DynamicPerception/NMX_3-Axis_Hardware/README.md

NMX_3-Axis_Hardware
===================

3-Axis version of the nanoMoCo controller with Bluetooth LE
