DynamicPerception/NMX_3-Axis_Hardware/NMX-200 Fab and Assm Files - Rev3/NMX-200_BOM-rev3.xls

Company: |  |  | Dynamic Perception
Device: |  |  | NMX-200-rev3
SMD Parts: |  |  | 78
Through Hole Parts : |  |  | 9
SMD Both Sides: |  |  | Yes
Designator | Value | Device | Package | Description | Manufacturer | Manufacturer Part # | Supplier | Supplier Part # | Qty / Board | Notes
S1 |  | TAC_SWITCH | TACTICLE_SWITCH_SMD_EVQP0_BOT | Momentary Switch | Panasonic Electronic Components | EVQ-P0Q02Q | Digi-Key | P12967SDKR-ND | 1
U10 |  | TXB0104PWR | TSSOP14 | 4-Bit Bi-Directional Level Shifter | Texas Instruments | TXB0104PWR | Digi-Key | 296-21929-6-ND | 1
C1, C4, C5, C7, C10, C11, C12, C13, C14, C15, C17, C18, C20 | .1uF | CAP0402-CAP | 0402-CAP | Capacitor | Taiyo Yuden | TMK105BJ104KV-F | Digi-Key | 587-1456-1-ND | 13
R18 | 0.01 | R-US_R1206 | R1206 | RESISTOR, American symbol | TE Connectivity | RLP73V2BR010JTD | Digi-Key | A109818DKR-ND | 1
R19 | 100 | R-US_R0402 | R0402 | RESISTOR, American symbol | Yageo | RC0402FR-07100RL | Digi-Key | 311-100LRDKR-ND | 1
C6 | 100uF | CAP_POLD | PANASONIC_D | Capacitor Polarized | Panasonic Electronic Components | EEE-1EA101XP | Digi-Key | PCE3898DKR-ND | 1
J2 | 10118193-0001LF | USB10118193-0001LF | 10118193-0001LF |  | FCI | 10118193-0001LF | Digi-Key | 609-4616-1-ND | 1
R4, R5, R8, R17, R20, R21, R22, R23, R24 | 10k | R-US_R0402 | R0402 | RESISTOR, American symbol | Yageo | RC0402FR-0710KL | Digi-Key | 311-10.0KLRTR-ND | 9
C2, C3, C19 | 10uF | CAP_POL1206 | EIA3216 | Capacitor Polarized | Kemet | T491A106M016AT | Digi-Key | 399-3687-6-ND | 3
R9 | 120 | R-US_R0402 | R0402 | RESISTOR, American symbol | Yageo | RC0402JR-07120RL | Digi-Key | 311-120JRDKR-ND | 1
C8, C9 | 12pF | CAP0402-CAP | 0402-CAP | Capacitor | TDK Corporation | C1005C0G1H120J050BA | Digi-Key | 445-1236-6-ND | 2
R2, R3, R13, R14 | 180 | R-US_R0402 | R0402 | RESISTOR, American symbol | Yageo | RC0402FR-07180RL | Digi-Key | 311-180LRDKR-ND | 4
C16 | 1uF | CAP0402-CAP | 0402-CAP | Capacitor | TDK Corporation | C1005X5R1C105K050BC | Digi-Key | 445-4978-6-ND | 1
R6, R7 | 22 | R-US_R0402 | R0402 | RESISTOR, American symbol | Yageo | RC0402JR-0722RL | Digi-Key | 311-22JRDKR-ND | 2
U9 | 3.2X2.5MM_CRYSTAL | 3.2X2.5MM_CRYSTAL | 3.2X2.5MM |  | AVX Corp/Kyocera Corp | CX3225SB16000E0FPZ25 | Digi-Key | 478-4815-6-ND | 1
R10, R11, R15, R16 | 330 | R-US_R0402 | R0402 | RESISTOR, American symbol | Yageo | RC0402FR-07330RL | Digi-Key | 311-330LRDKR-ND | 4
R25 | 40.2k | R-US_R0402 | R0402 | RESISTOR, American symbol | Yageo | RC0402FR-0740K2L | Digi-Key | 311-40.2KLRDKR-ND | 1
R1, R12 | 5.1k | R-US_R0402 | R0402 | RESISTOR, American symbol | Yageo | RC0402JR-075K1L | Digi-Key | 311-5.1KJRDKR-ND | 2
U14 | ACPL-247 | ACPL-247 | 16-SOIC |  | Avago Technologies US Inc. | ACPL-247-500E | Digi-Key | 516-2219-6-ND | 1
IC1 | AT90USB1287-AU | AT90USB1287-AU | TQFP64 | Atmel AT90USB1287 | Atmel | AT90USB1287-AU | Digi-Key | AT90USB1287-AU-ND | 1
IC2 | AT90USB1287-MU | AT90USB1287-MU | MLF64 | Atmel AT90USB1287 | Atmel | AT90USB1287-MU | Digi-Key | AT90USB1287-MURDKR-ND | 1 | Alternate for AT90USB1287-AU. Quote and use only if AT90USB1287-AU is not in stock.
U11 | BLE112 | BLE112 | BLE112-A | Bluetooth low energy single mode module is a single mode device targeted for low power sensors and accessories. | BlueGiga Technologies Inc | BLE112-A-V1 | Digi-Key | 1446-1017-6-ND | 1
T3 | CMPT2369 | BCW60-NPN-SOT23-BEC | SOT23-BEC | NPN Transistror | Fairchild Semiconductor | BC847BMTF | Digi-Key | BC847BMTFDKR-ND | 1
T1, T2 | CMPT2369 | BCW60-NPN-SOT23-BEC | SOT23-BEC | NPN Transistror | Rohm Semiconductor | 2SD1757KT146Q | Digi-Key | 2SD1757KT146QDKR-ND | 2
LED1 | Connected | LED0603 | LED-0603 | LEDs | Lite-On Inc | LTST-S270TBKT | Digi-Key | 160-1650-6-ND | 1
D3 | DIODE-SCHOTTKY-BAT20J | DIODE-SCHOTTKY-BAT20J | SOD-323 | Schottky diodes in SFE's production catalog | NXP Semiconductors | PMEG3010BEA,115 | Digi-Key | 568-6511-6-ND | 1
U2 | FDS6681Z | MOSFET_P-CHANNEL | DSO-8 |  | Fairchild Semiconductor | FDS6681Z | Digi-Key | FDS6681ZDKR-ND | 1
JP2 | HEADER_5X2_0.05IN | HEADER_5X2_0.05IN | HEADER_5X2_0.05IN |  | FCI | 20021121-00010T4LF | Digi-Key | 609-3729-ND | 1
FB1, FB2, FB3 | HZ0402B102R-10 | R-US_R0402 | R0402 | RESISTOR, American symbol | Laird-Signal Integrity Products | HZ0402B102R-10 | Digi-Key | 240-2555-6-ND | 3
JP1 | ICSP | PINHD-2X3 | 2X03 | PIN HEADER | FCI | 67996-406HLF | Digi-Key | 609-3218-ND | 1
U7 | ISL8483 | SN65176D | SO-08 | DIFFERENTIAL BUS TRANSCEIVER | TEXAS INSTRUMENTS | SN65176BD | Digi-Key | 296-14636-6-ND | 1
J1 | PJ-002AH | DC_JACK | DC_JACK_KLDX |  | CUI Inc | PJ-002AH | Digi-Key | CP-002AH-ND | 1
U15 | LMP8640MK | LMP8640MK | 6-SOT |  | Texas Instruments | LMP8640MK-H/NOPB | Digi-Key | LMP8640MK-H/NOPBDKR-ND | 1
U12 | LP2981A-33DBVR | V_REG_LDOSMD | SOT23-5 | Voltage Regulator LDO | Texas Instruments | LP2981A-33DBVR | Digi-Key | 296-17361-6-ND | 1
JP3, JP4 | M12PTH | M12PTH | 1X12 | Header 12 | Sullins Connector Solutions | PPTC121LFBN-RC | Digi-Key | S6100-ND | 2
D2 | MBRX160-TP | DIODE-SOD123 | SOD123 | Z-Diode | Fairchild Semiconductor | MMSZ5253B | Digi-Key | MMSZ5253BDKR-ND | 1
U1 | MC78M05BDTG | VOLTAGE_REG | DPAK-3 |  | ON Semiconductor | MC78M05BDTRKG | Digi-Key | MC78M05BDTRKGOSCT-ND | 1
F1 | MF-SM050-2-99 | PTC2920 | PTC-2920 | Resettable Fuse PTC | Bel Fuse | 0ZCD0050FF2C | Digi-Key | 507-1365-6-ND | 1
D1 | MMSZ4697-V-GS08 | ZENER-DIODESOD123 | SOD123 | Z-Diode | Vishay Semiconductor Diodes Division | MMSZ4697-E3-08 | Digi-Key | MMSZ4697-E3-08DKR-ND | 1
Q1 | P-CHANNEL_MOSFET | P-CHANNEL_MOSFET | SOT23-3 |  | Fairchild Semiconductor | FDV304P | Digi-Key | FDV304PDKR-ND | 1
U5, U6, U13 | PRTR5V0U4D | PRTR5V0U4D | SOT23-6 |  | NXP Semiconductors | PRTR5V0U4D | Digi-Key | 568-4146-6-ND | 4
J4 | RJHSE-5385-02 | RJ45_DOUBLEPTH | RJHSE-5385-02 | RJ45 Connectors - Double | Amphenol Commercial Products | RJHSE-5385-02 | Digi-Key | RJHSE-5385-02-ND | 1
J3, J5, J6 | SJ1-2503A | TRS_JACKSJ1-2503A | SJ1-2503A | TRS Jacks | CUI Inc | SJ1-2503A | Digi-Key | CP1-2503A-ND | 3
U8, U16, U17, U18 | TVS_SMA | TVS_SMA | DO-214AC / SMA | TVS Diode | Bourns Inc | SMAJ48CA | Digi-Key | SMAJ48CABCT-ND | 4
