DynamicPerception/NMX_3-Axis_Hardware/NMX-201-B Fab and Assm Files - Rev2/NMX-201-B_BOM-rev2.xls

Company: |  |  | Dynamic Perception
Device: |  |  | NMX-201-b-Rev2
SMD Parts: |  |  | 47
Through Hole Parts : |  |  | 6
SMD Both Sides: |  |  | Yes
Designator | Value | Device | Package | Description | Manufacturer | Manufacturer Part # | Supplier | Supplier Part # | Qty / Board
LED1, LED2, LED3 |  | LED0603 | LED-0603 | LEDs | OSRAM Opto Semiconductors Inc | LB Q39G-L2N2-35-1 | Digi-Key | 475-2816-6-ND | 3
C1, C2, C3, C4, C6, C7, C9, C10, C11, C12, C14, C15, C18, C19, C20 | .1uF | CAP0402-CAP | 0402-CAP | Capacitor | Taiyo Yuden | TMK105BJ104KV-F | Digi-Key | 587-1456-6-ND | 15
C5, C8, C13 | .22uF | CAP0402-CAP | 0402-CAP | Capacitor | Taiyo Yuden | TMK105BJ224KVHF | Digi-Key | 587-3809-6-ND | 3
R1, R2, R7, R8, R12, R13 | 0.1 | R-US_R0603 | R0603 | RESISTOR, American symbol | Samsung Electro-Mechanics America | RU1608FR100CS | Digi-Key | 1276-6155-6-ND | 6
C17 | 100uF | CAP_POLD | PANASONIC_D | Capacitor Polarized | Panasonic Electronic Components | EEE-1EA101XP | Digi-Key | PCE3898DKR-ND | 1
R4, R6, R11, R19 | 10K | R-US_R0402_B | R0402_BOTTOM | RESISTOR, American symbol | Yageo | RC0402FR-0710KL | Digi-Key | 311-10.0KLRDKR-ND | 4
C16 | 10uF | CAP_POL1206 | EIA3216 | Capacitor Polarized | Kemet | T491A106M016AT | Digi-Key | 399-3687-6-ND | 1
R5, R9, R14 | 20k | R-US_R0402_B | R0402_BOTTOM | RESISTOR, American symbol | Yageo | RC0402FR-0720KL | Digi-Key | 311-20.0KLRDKR-ND | 3
R16, R17, R18 | 430 | R-US_R0402_B | R0402_BOTTOM | RESISTOR, American symbol | Yageo | RC0402FR-07430RL | Digi-Key | 311-430LRDKR-ND | 3
R3, R10, R15 | 49.9k | R-US_R0402_B | R0402_BOTTOM | RESISTOR, American symbol | Yageo | RC0402FR-0749K9L | Digi-Key | 311-49.9KLRDKR-ND | 3
IC1, IC2, IC3 | A4983TOP | A4983TOP | QFN28ET | DMOS Microstepping Driver with Translator | Allegro Microsystems | A4983SETTR-T | Digi-Key | 620-1194-6-ND | 3
U1, U2, U5 | CADJ | TC33X-2 | 3MM_SMD | Trimming Potentiometer | Bourns Inc | TC33X-2-103E | Digi-Key | TC33X-103EDKR-ND | 3
JP3, JP4 | M12PTH | M12PTH | 1X12 | Header 12 | Molex Inc | 901200132 | Digi-Key | WM8082-ND | 2
J1, J2, J3 | MOLEX-4-RA | MOLEX-4-RA | DYNAMIC PERCEPTION HANGING CABLE | Hanging Cable | N/A | N/A | N/A | N/A | 3
S1 | TAC_SWITCH | TAC_SWITCH | TAC_SWITCH_THR | Tactile Switch | TE Connectivity | 2-1825027-0 | Digi-Key | 450-1661-ND | 1
