DynamicPerception/NMX_3-Axis_Hardware/NMX-200_rev3_schematic.pdf

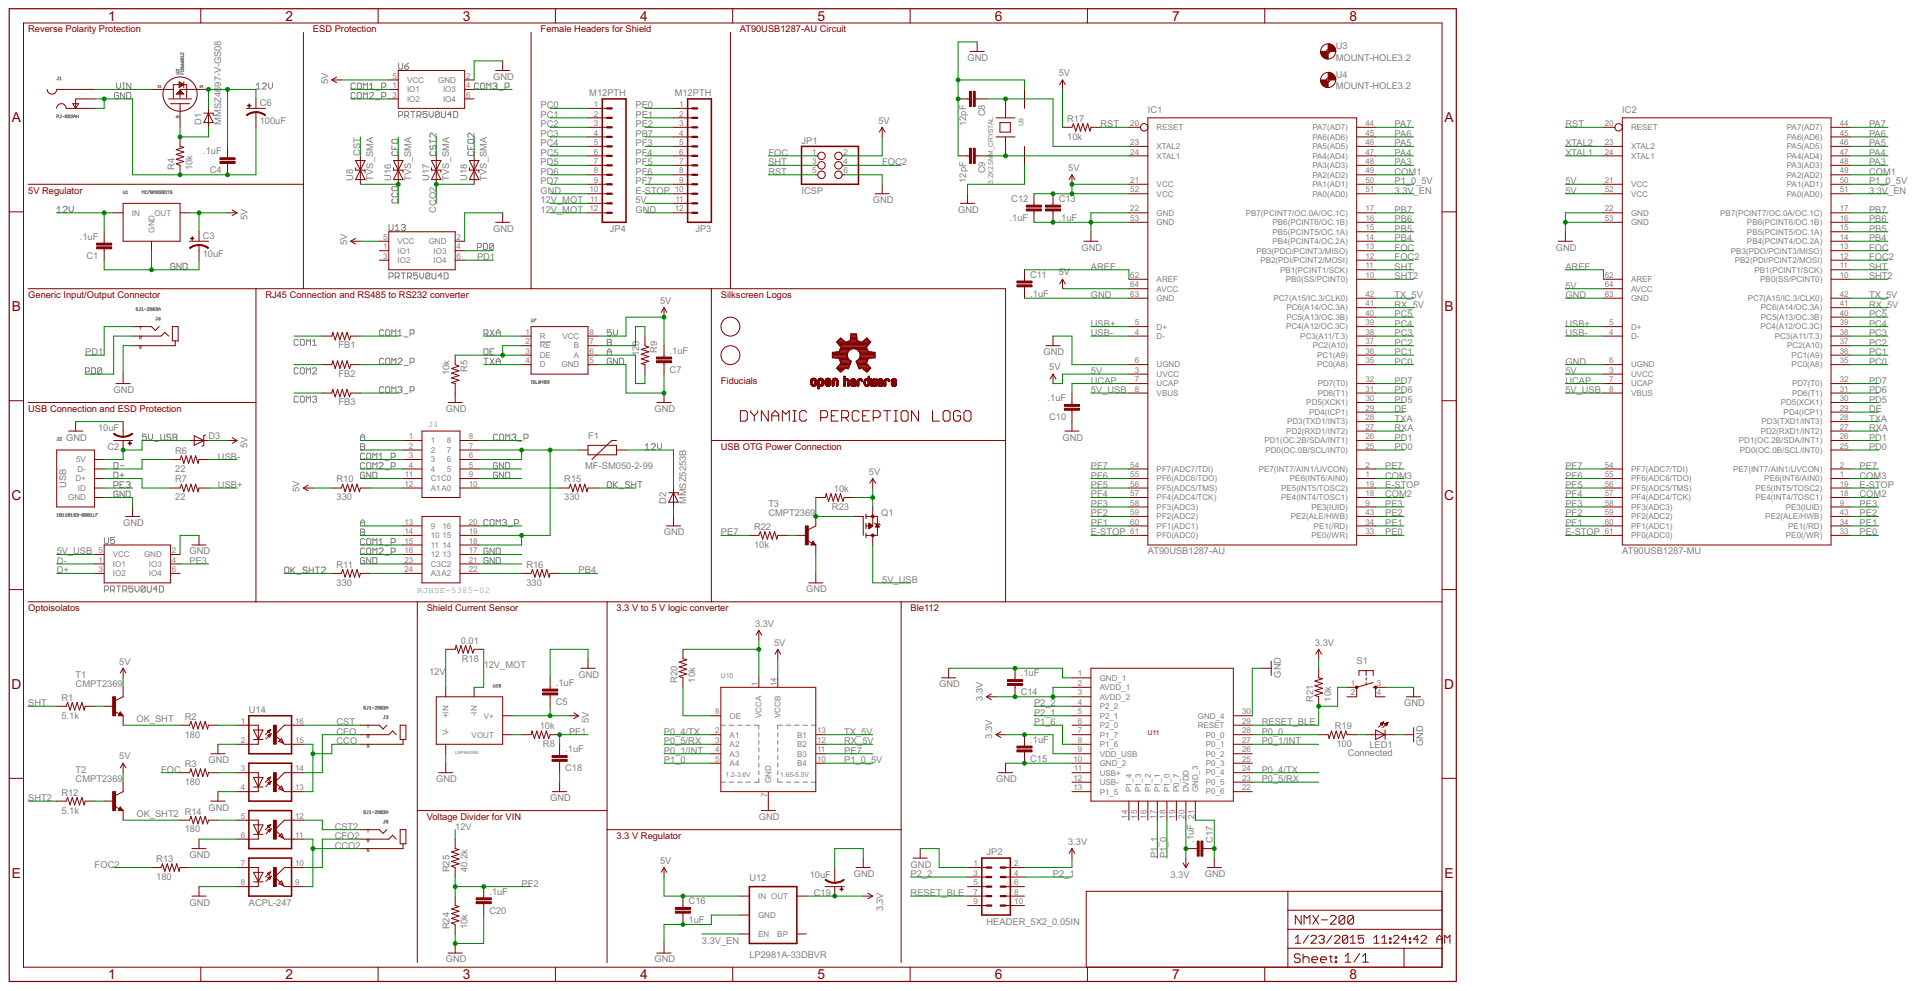
[picture p1: page 1]

Reverse Polarity Protection | ESD Protection | Female Headers for Shield | AT90USB1287-AU Circuit

Generic Input/Output Connector

RJ45 Connection and RS485 to RS232 converter

USB Connection and ESD Protection

USB OTG Power Connection

Voltage Divider for VIN
