DynamicPerception/NMX_3-Axis_Hardware/NMX-201.pdf

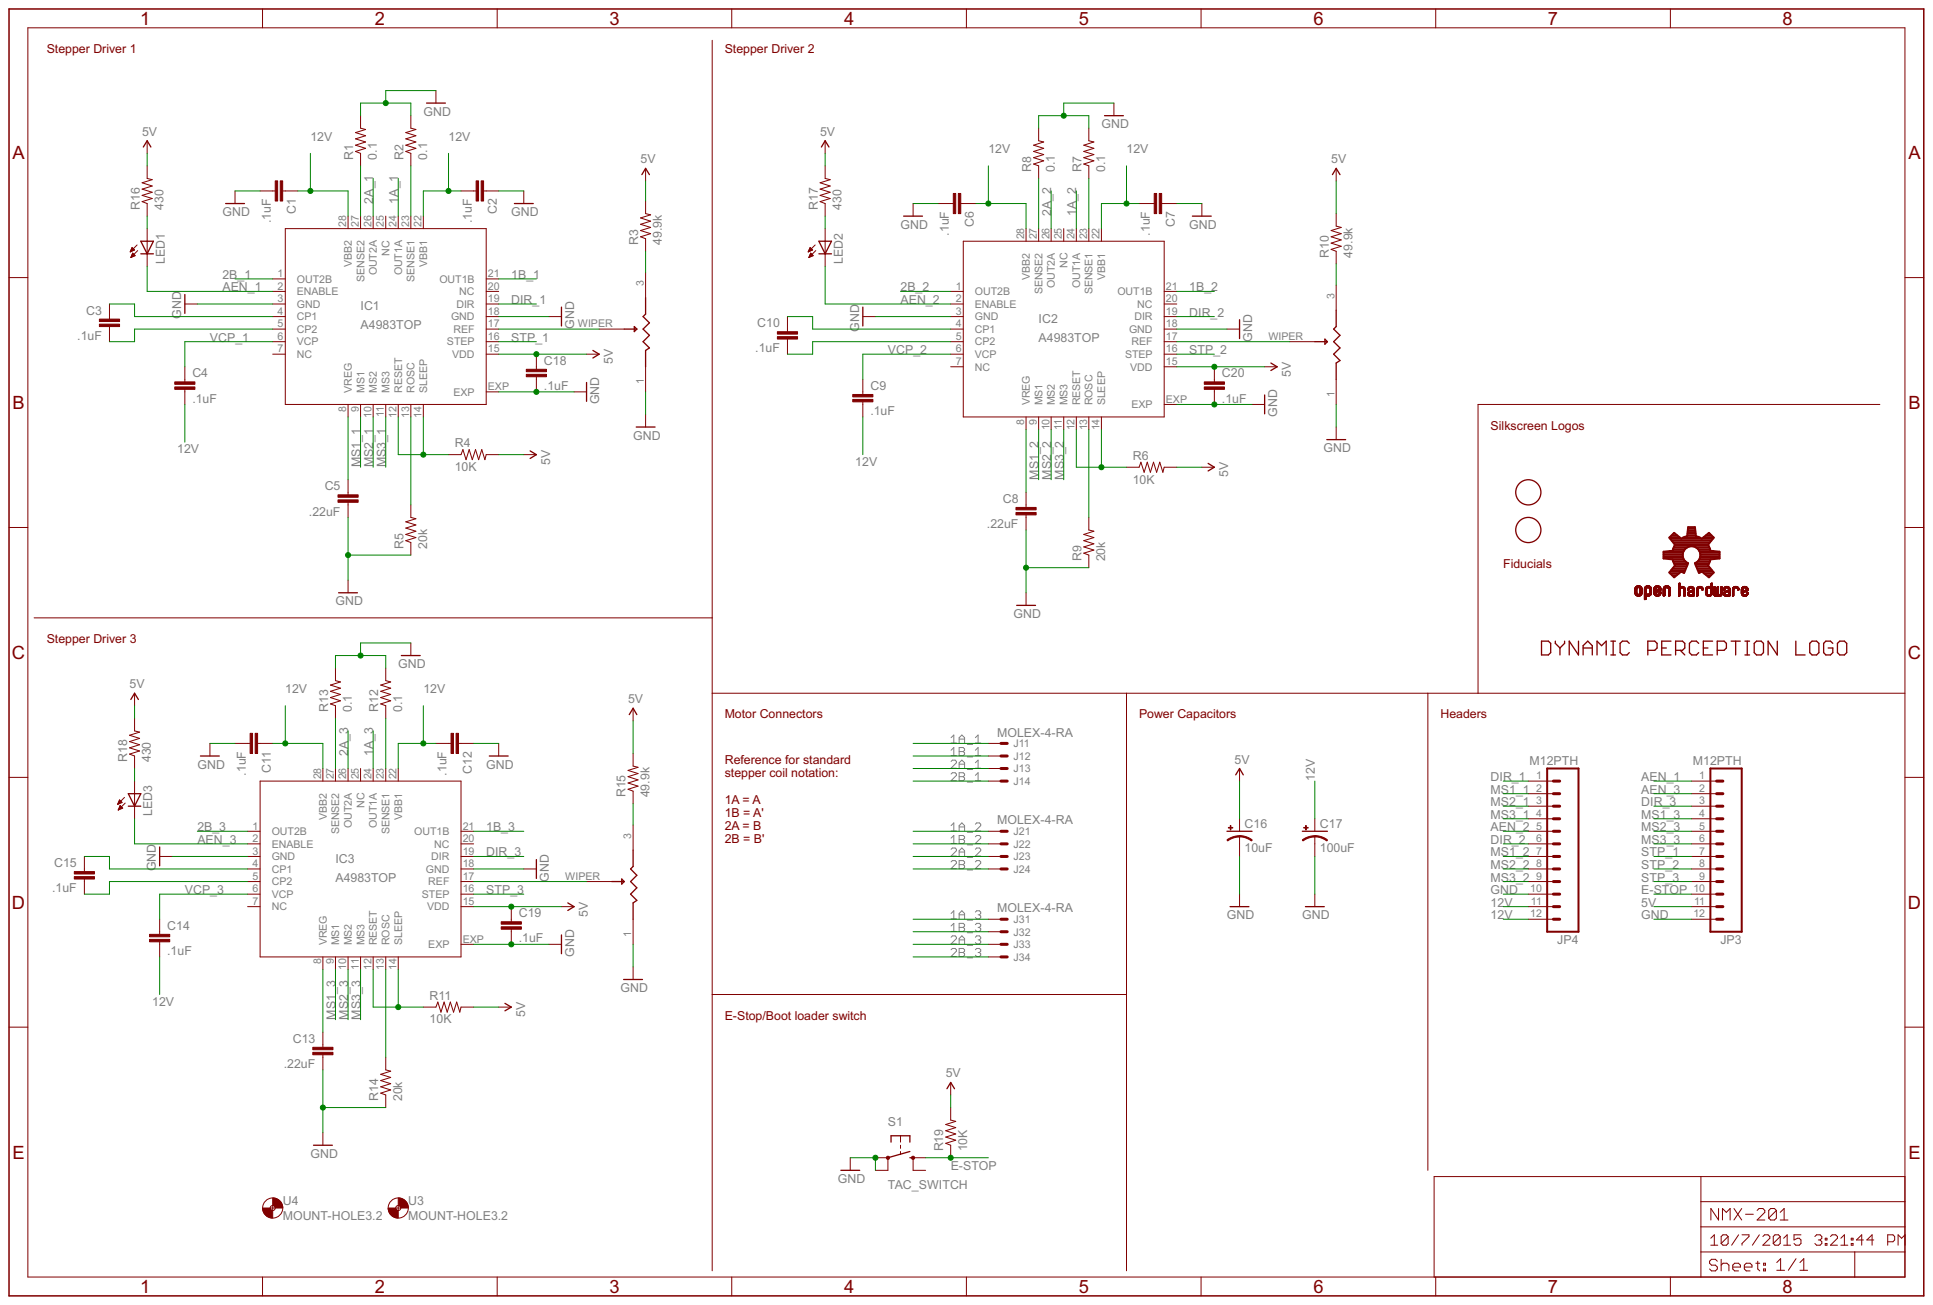
[picture p2: page 1]

E-Stop/Boot loader switch
