DynamicPerception/NMX_3-Axis_Hardware/NMX-201-B Fab and Assm Files - Rev2/NMX-201-B_assm_drawing_bottom-rev2.pdf

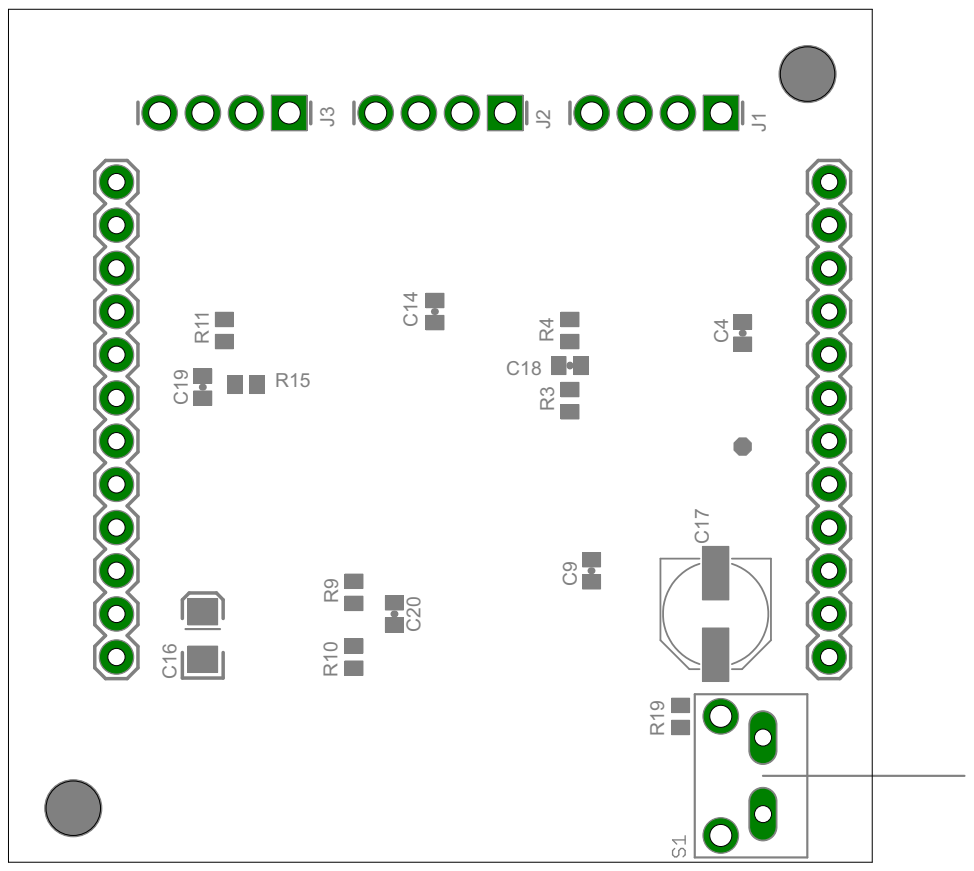
[picture p3: page 1]
