DynamicPerception/NMX_3-Axis_Hardware/NMX-201-B Fab and Assm Files - Rev2/NMX-201-B_assm_drawing_top-rev2.pdf

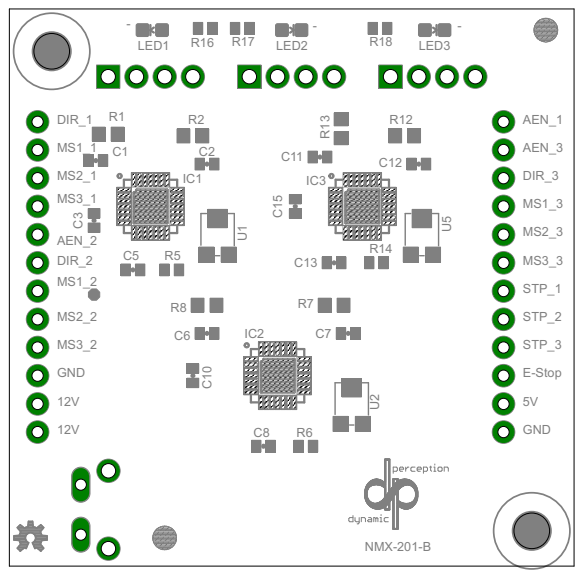
[picture p4: page 1]
