DynamicPerception/NMX_3-Axis_Hardware/NMX-200 Fab and Assm Files - Rev3/NMX-200_assm_drawing_bottom-rev3.pdf

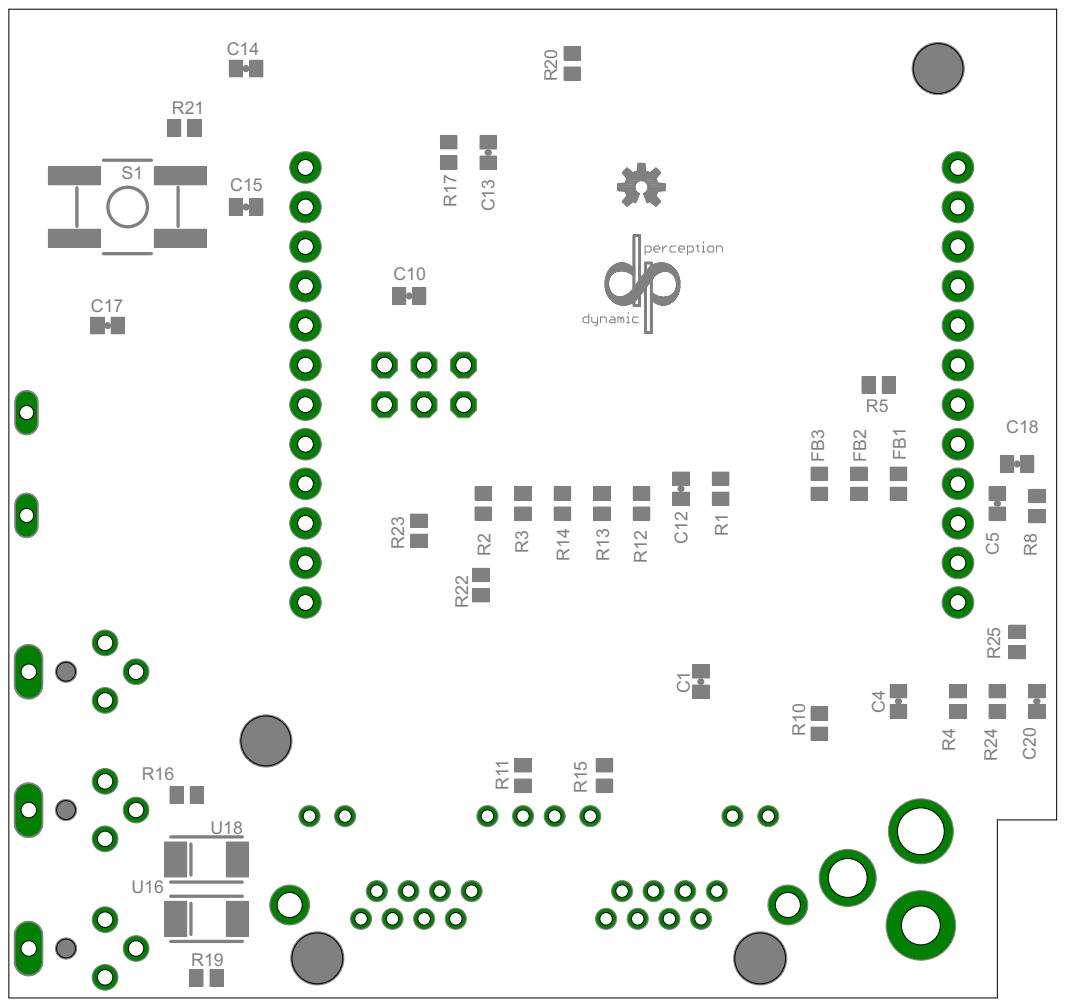
[picture p5: page 1]
