DynamicPerception/NMX_3-Axis_Hardware/NMX-201 Fab and Assm Files - Rev2/NMX-201_assm_drawing_bottom-rev2.pdf

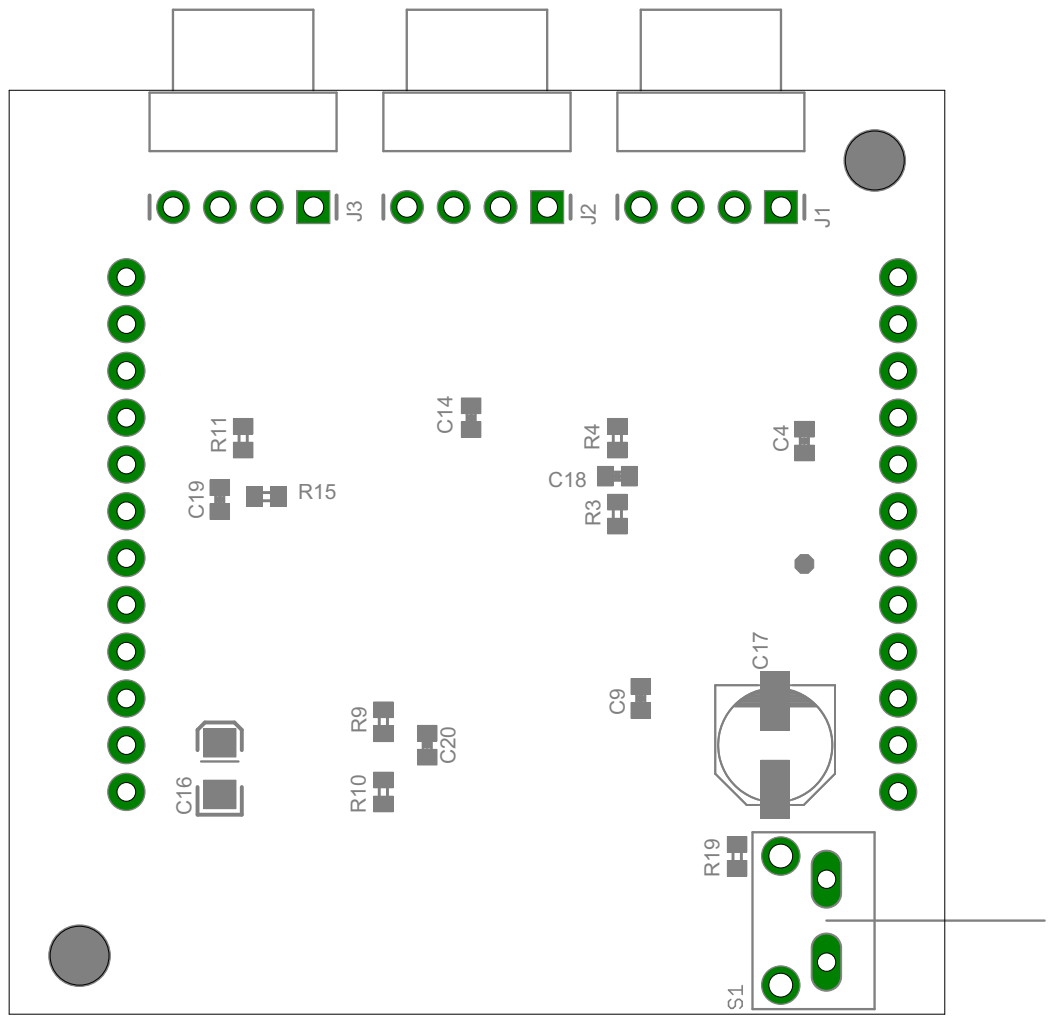
[picture p7: page 1]
