DynamicPerception/NMX_3-Axis_Hardware/NMX-200.brd

## EAGLE design NMX-200.brd (2017-01-27)

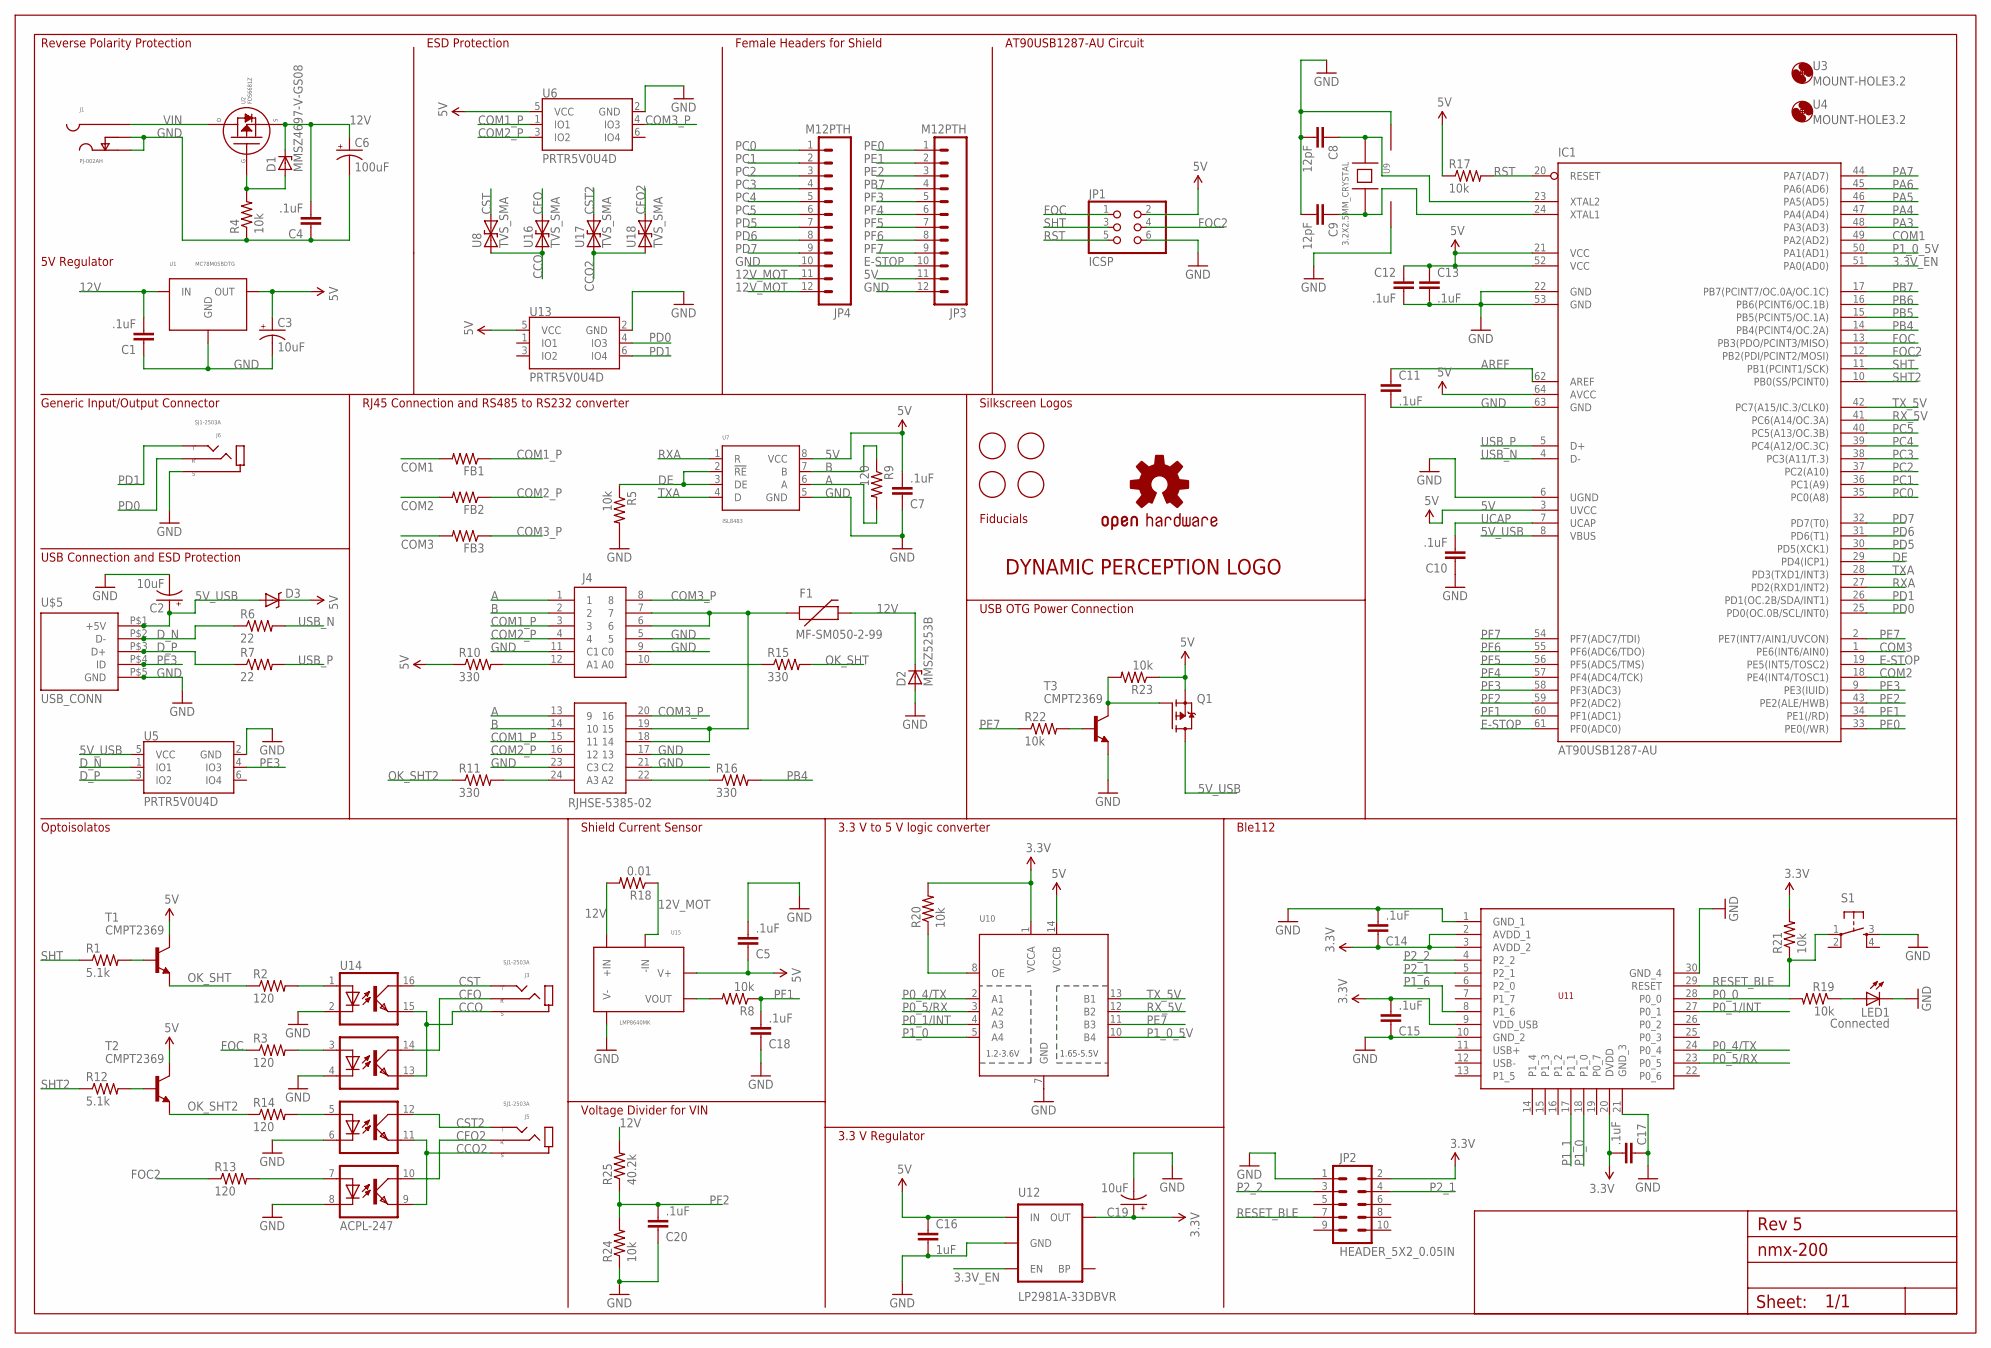
[picture p9: schematic NMX-200.sch]

Parts:
C1, C4, C5, C7, C10, C11, C12, C13, C14, C15, C17, C18, C20: .1uF; 0402-CAP; MPN TMK105BJ104KV-F
C2, C3, C19: 10uF; EIA3216; MPN T491A106M016AT
C6: 100uF; PANASONIC_D; MPN EEE-1EA101XP
C8, C9: 12pF; 0402-CAP; MPN C1005C0G1H120J050BA
C16: 1uF; 0402-CAP; MPN C1005X5R1C105K050BC
D1: MMSZ4697-V-GS08; SOD123; MPN MMSZ4697-E3-08
D2: MMSZ5253B; SOD123; MPN MMSZ5253B
D3: DIODE-SCHOTTKY-BAT20J; SOD-323; MPN PMEG3010BEA,115
F1: MF-SM050-2-99; PTC-2920; MPN 0ZCD0050FF2C
FB1, FB2, FB3: HZ0402B102R-10; R0402; MPN HZ0402B102R-10
FRAME2: A3L-LOCSILK_SCREEN; DRAWING_NAME
IC1: AT90USB1287-AU; TQFP64; MPN AT90USB1287-AU
J1: PJ-002AH; DC_JACK_KLDX; MPN PJ-002AH
J3, J5, J6: SJ1-2503A; MPN SJ1-2503A
J4: RJHSE-5385-02; MPN RJHSE-5385-02
JP1: ICSP; 2X03; MPN 67996-406HLF
JP2: HEADER_5X2_0.05IN; MPN 20021121-00010T4LF
JP3, JP4: M12PTH; 1X12; MPN PPTC121LFBN-RC
LED1: Connected; LED-0603; MPN LTST-S270TBKT
Q1: P-CHANNEL_MOSFET; SOT23-3; MPN FDV304P
R1, R12: 5.1k; R0402; MPN RC0402JR-075K1L
R2, R3, R13, R14: 120; R0402; MPN RC0402FR-07180RL
R4, R5, R8, R17, R20, R21, R22, R23, R24: 10k; R0402; MPN RC0402FR-0710KL
R6, R7: 22; R0402; MPN RC0402JR-0722RL
R9: 120; R0402; MPN RC0402JR-07120RL
R10, R11, R15, R16: 330; R0402; MPN RC0402FR-07330RL
R18: 0.01; R1206; MPN RLP73V2BR010JTD
R19: 10k; R0402; MPN RC0402FR-0714KL
R25: 40.2k; R0402; MPN RC0402FR-0740K2L
S1: TAC_SWITCH; TACTICLE_SWITCH_SMD_EVQP0_BOT; MPN EVQ-P0Q02Q
T1, T2: CMPT2369; SOT23-BEC; MPN 2SD1757KT146Q
T3: CMPT2369; SOT23-BEC; MPN BC847BMTF
U1: MC78M05BDTG; DPAK-3; MPN MC78M05BDTRKG
U2: FDS6681Z; DSO-8; MPN FDS6681Z
U3, U4: MOUNT-HOLE3.2; 3,2
U5, U6, U13: PRTR5V0U4D; SOT23-6; MPN PRTR5V0U4D
U7: ISL8483; SO-08; MPN SN65176BD
U8, U16, U17, U18: TVS_SMA; SMA_DIODE; MPN SMAJ48CA
U9: 3.2X2.5MM_CRYSTAL; 3.2X2.5MM; MPN CX3225SB16000E0FPZ25
U10: TXB0104PWR; TSSOP14; MPN TXB0104PWR
U11: BLE112; BLE112-A; MPN BLE112-A-V1
U12: LP2981A-33DBVR; SOT23-5; MPN LP2981A-33DBVR
U14: ACPL-247; 16-SOIC; MPN ACPL-247-500E
U15: LMP8640MK; 6-SOT; MPN LMP8640MK-H/NOPB
U$1: DP_LOGOMICRO; DP_LOGO_MICRO
U$2: OSHW-LOGOS; OSHW-LOGO-S
U$3, U$4, U$6, U$7: FIDUCIAL; FIDUCIAL_1MM
U$5: USB_CONN; 10118194-0001LF

Connections:
3.3V: C14.1, C15.2, C17.2, C19.A (+), JP2.2, R20.2, R21.2, U10.1 (VCCA), U11.2 (AVDD_1), U11.3 (AVDD_2), U11.9 (VDD_USB), U11.20 (DVDD), U12.5 (OUT)
3.3V_EN: IC1.51 (PA0(AD0)), U12.3 (EN)
5V: C3.A (+), C5.1, C7.2, C12.1, C13.1, C16.1, D3.C, IC1.3 (UVCC), IC1.21 (VCC), IC1.52 (VCC), IC1.64 (AVCC), JP1.2, JP3.11, Q1.S, R10.1, R17.1, R23.1, T1.C, T2.C, U1.2 (OUT), U6.5 (VCC), U7.8 (VCC), U10.14 (VCCB), U12.1 (IN), U13.5 (VCC), U15.6 (V+)
5V_USB: C2.A (+), D3.A, IC1.8 (VBUS), Q1.D, U5.5 (VCC), U$5.P$1 (+5V)
12V: C1.2, C4.2, C6.+, D1.C, D2.C, F1.P$2 (2), R18.2, R25.2, U1.1 (IN), U2.1 (SOURCE), U2.2 (SOURCE), U2.3 (SOURCE), U15.3 (+IN)
12V_MOT: JP4.11, JP4.12, R18.1, U15.4 (-IN)
A: J4.1, J4.13 (9), R9.2, U7.6 (A)
AREF: C11.1, IC1.62 (AREF)
B: J4.2, J4.14 (10), R9.1, U7.7 (B)
CCO: J3.1 (S), U8.C (1), U14.13, U14.15, U16.C (1)
CCO2: J5.1 (S), U14.9, U14.11, U17.C (1), U18.C (1)
CFO: J3.4 (R), U14.14, U16.A (2)
CFO2: J5.4 (R), U14.10, U18.A (2)
COM1: FB1.2, IC1.49 (PA2(AD2))
COM1_P: FB1.1, J4.3, J4.15 (11), U6.1 (IO1)
COM2: FB2.2, IC1.18 (PE4(INT4/TOSC1))
COM2_P: FB2.1, J4.4, J4.16 (12), U6.3 (IO2)
COM3: FB3.2, IC1.1 (PE6(INT6/AIN0))
COM3_P: FB3.1, J4.8, J4.20 (16), U6.4 (IO3)
CST: J3.2 (T), J3.3 (T), U8.A (2), U14.16
CST2: J5.2 (T), J5.3 (T), U14.12, U17.A (2)
DE: IC1.29 (PD4(ICP1)), R5.1, U7.2 (!RE), U7.3 (DE)
D_N: R6.1, U5.1 (IO1), U$5.P$2 (D-)
D_P: R7.1, U5.3 (IO2), U$5.P$3 (D+)
E-STOP: IC1.19 (PE5(INT5/TOSC2)), IC1.61 (PF0(ADC0)), JP3.10
FOC: IC1.13 (PB3(PDO/PCINT3/MISO)), JP1.1, R3.1
FOC2: IC1.12 (PB2(PDI/PCINT2/MOSI)), JP1.4, R13.1
GND: C1.1, C2.C (-), C3.C (-), C4.1, C5.2, C6.-, C7.1, C8.2, C9.2, C10.1, C11.2, C12.2, C13.2, C14.2, C15.1, C16.2, C17.1, C18.1, C19.C (-), C20.1, D2.A, IC1.6 (UGND), IC1.22 (GND), IC1.53 (GND), IC1.63 (GND), J1.GND (SLEEVE), J1.GNDBREAK (SLEEVE_SHUNT), J4.5, J4.9 (C0), J4.11 (C1), J4.17 (13), J4.21 (C2), J4.23 (C3), J6.1 (S), JP1.6, JP2.1, JP3.12, JP4.10, LED1.C, R4.1, R5.2, R24.1, S1.3, T3.E, U1.4 (GND), U5.2 (GND), U6.2 (GND), U7.5 (GND), U9.2 (GND), U9.4, U10.7 (GND), U11.1 (GND_1), U11.10 (GND_2), U11.21 (GND_3), U11.30 (GND_4), U12.2 (GND), U13.2 (GND), U14.2, U14.4, U14.6, U14.8, U15.2 (V-), U$5.P$5 (GND)
unnamed: R20.1, U10.8 (OE)
unnamed: R22.2, T3.B
unnamed: LED1.A, R19.1
unnamed: J4.10 (A0), R15.1
unnamed: D1.A, R4.2, U2.4 (GATE)
unnamed: R2.2, U14.1
unnamed: R3.2, U14.3
unnamed: R8.2, U15.1 (VOUT)
unnamed: R14.2, U14.5
unnamed: R13.2, U14.7
unnamed: J4.12 (A1), R10.2
unnamed: J4.24 (A3), R11.2
unnamed: Q1.G, R23.2, T3.C
unnamed: J4.22 (A2), R16.1
unnamed: F1.P$1 (1), J4.6, J4.7, J4.18 (14), J4.19 (15)
unnamed: R1.2, T1.B
unnamed: R12.2, T2.B
OK_SHT: R2.1, R15.2, T1.E
OK_SHT2: R11.1, R14.1, T2.E
P0_0: R19.2, U11.28 (P0_0)
P0_1/INT: U10.4 (A3), U11.27 (P0_1)
P0_4/TX: U10.2 (A1), U11.24 (P0_4)
P0_5/RX: U10.3 (A2), U11.23 (P0_5)
P1_0: U10.5 (A4), U11.18 (P1_0)
P1_0_5V: IC1.50 (PA1(AD1)), U10.10 (B4)
P1_1: U11.17 (P1_1)
P1_6: U11.8 (P1_6)
P2_1: JP2.4, U11.5 (P2_1)
P2_2: JP2.3, U11.4 (P2_2)
PA3: IC1.48 (PA3(AD3))
PA4: IC1.47 (PA4(AD4))
PA5: IC1.46 (PA5(AD5))
PA6: IC1.45 (PA6(AD6))
PA7: IC1.44 (PA7(AD7))
PB4: IC1.14 (PB4(PCINT4/OC.2A)), R16.2
PB5: IC1.15 (PB5(PCINT5/OC.1A))
PB6: IC1.16 (PB6(PCINT6/OC.1B))
PB7: IC1.17 (PB7(PCINT7/OC.0A/OC.1C)), JP3.4
PC0: IC1.35 (PC0(A8)), JP4.1
PC1: IC1.36 (PC1(A9)), JP4.2
PC2: IC1.37 (PC2(A10)), JP4.3
PC3: IC1.38 (PC3(A11/T.3)), JP4.4
PC4: IC1.39 (PC4(A12/OC.3C)), JP4.5
PC5: IC1.40 (PC5(A13/OC.3B)), JP4.6
PD0: IC1.25 (PD0(OC.0B/SCL/INT0)), J6.4 (R), U13.4 (IO3)
PD1: IC1.26 (PD1(OC.2B/SDA/INT1)), J6.2 (T), J6.3 (T), U13.6 (IO4)
PD5: IC1.30 (PD5(XCK1)), JP4.7
PD6: IC1.31 (PD6(T1)), JP4.8
PD7: IC1.32 (PD7(T0)), JP4.9
PE0: IC1.33 (PE0(/WR)), JP3.1
PE1: IC1.34 (PE1(/RD)), JP3.2
PE2: IC1.43 (PE2(ALE/HWB)), JP3.3
PE3: IC1.9 (PE3(IUID)), U5.4 (IO3), U$5.P$4 (ID)
PE7: IC1.2 (PE7(INT7/AIN1/UVCON)), R22.1, U10.11 (B3)
PF1: C18.2, IC1.60 (PF1(ADC1)), R8.1
PF2: C20.2, IC1.59 (PF2(ADC2)), R24.2, R25.1
PF3: IC1.58 (PF3(ADC3)), JP3.5
PF4: IC1.57 (PF4(ADC4/TCK)), JP3.6
PF5: IC1.56 (PF5(ADC5/TMS)), JP3.7
PF6: IC1.55 (PF6(ADC6/TDO)), JP3.8
PF7: IC1.54 (PF7(ADC7/TDI)), JP3.9
RESET_BLE: JP2.7, R21.1, S1.1, U11.29 (RESET)
RST: IC1.20 (RESET), JP1.5, R17.2
RXA: IC1.27 (PD2(RXD1/INT2)), U7.1 (R)
RX_5V: IC1.41 (PC6(A14/OC.3A)), U10.12 (B2)
SHT: IC1.11 (PB1(PCINT1/SCK)), JP1.3, R1.1
SHT2: IC1.10 (PB0(SS/PCINT0)), R12.1
TXA: IC1.28 (PD3(TXD1/INT3)), U7.4 (D)
TX_5V: IC1.42 (PC7(A15/IC.3/CLK0)), U10.13 (B1)
UCAP: C10.2, IC1.7 (UCAP)
USB_N: IC1.4 (D-), R6.2
USB_P: IC1.5 (D+), R7.2
VIN: J1.PWR (PIN), U2.5 (DRAIN), U2.6 (DRAIN), U2.7 (DRAIN), U2.8 (DRAIN)
XTAL1: C9.1, IC1.24 (XTAL1), U9.3
XTAL2: C8.1, IC1.23 (XTAL2), U9.1

Notes on the sheet:
Ble112
3.3 V to 5 V logic converter
3.3 V Regulator
Optoisolatos
Reverse Polarity Protection
5V Regulator
Generic Input/Output Connector
USB Connection and ESD Protection
RJ45 Connection and RS485 to RS232 converter
ESD Protection
Female Headers for Shield
AT90USB1287-AU Circuit
Shield Current Sensor
Voltage Divider for VIN
USB OTG Power Connection
Silkscreen Logos
Fiducials
Rev 5

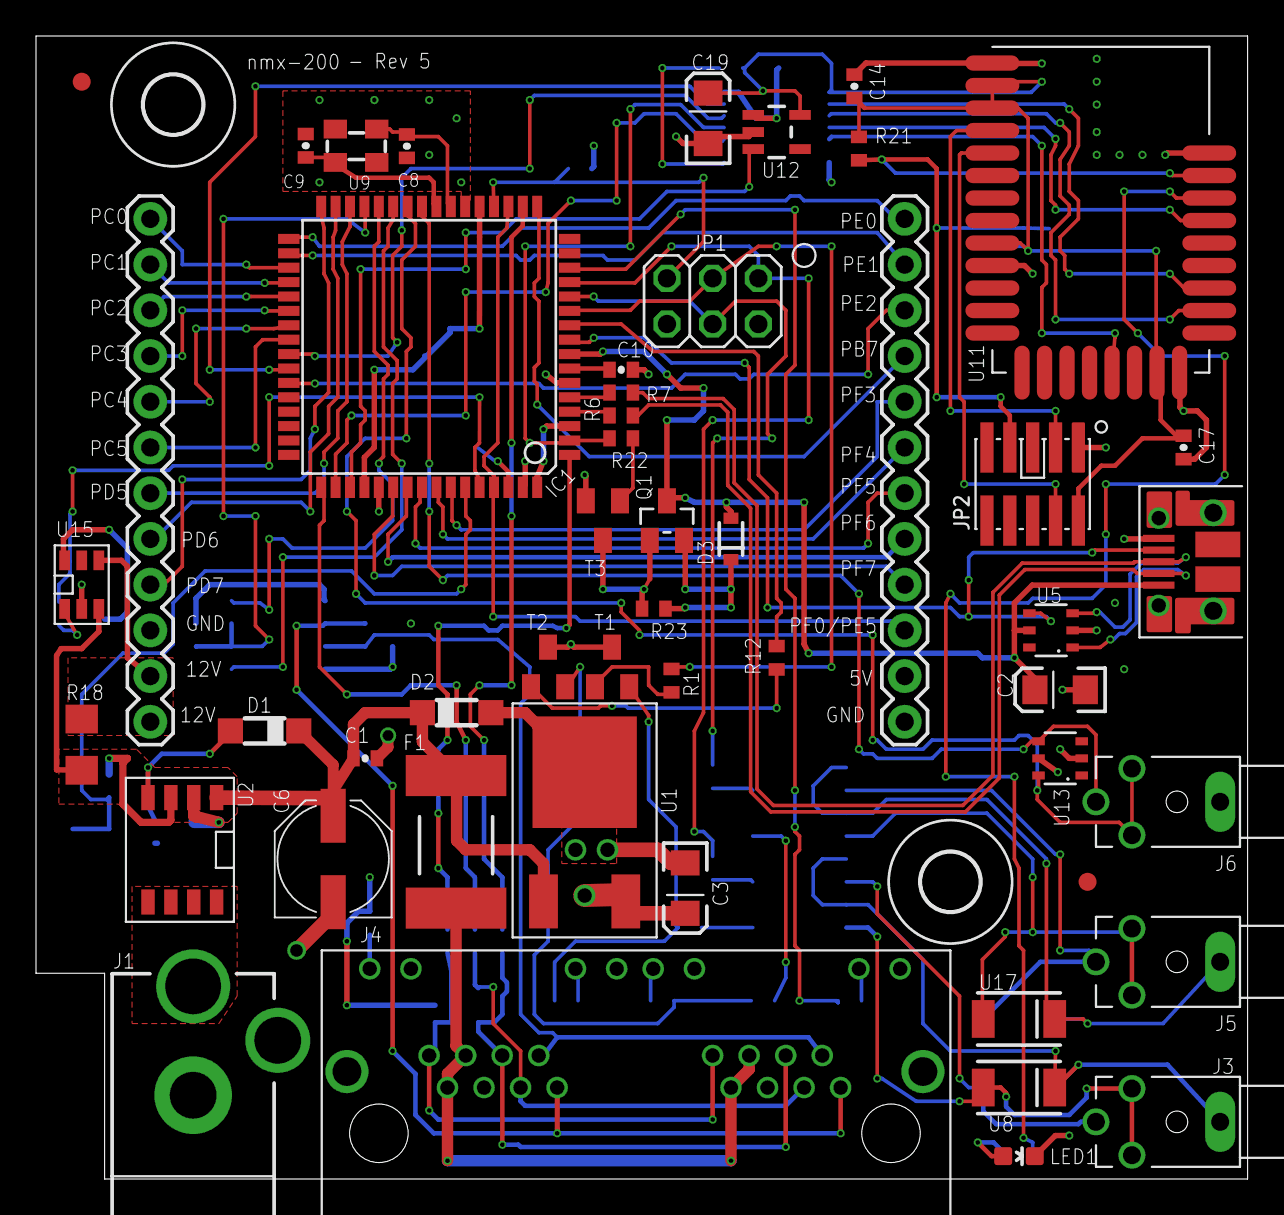
[picture p10: board NMX-200.brd from above]

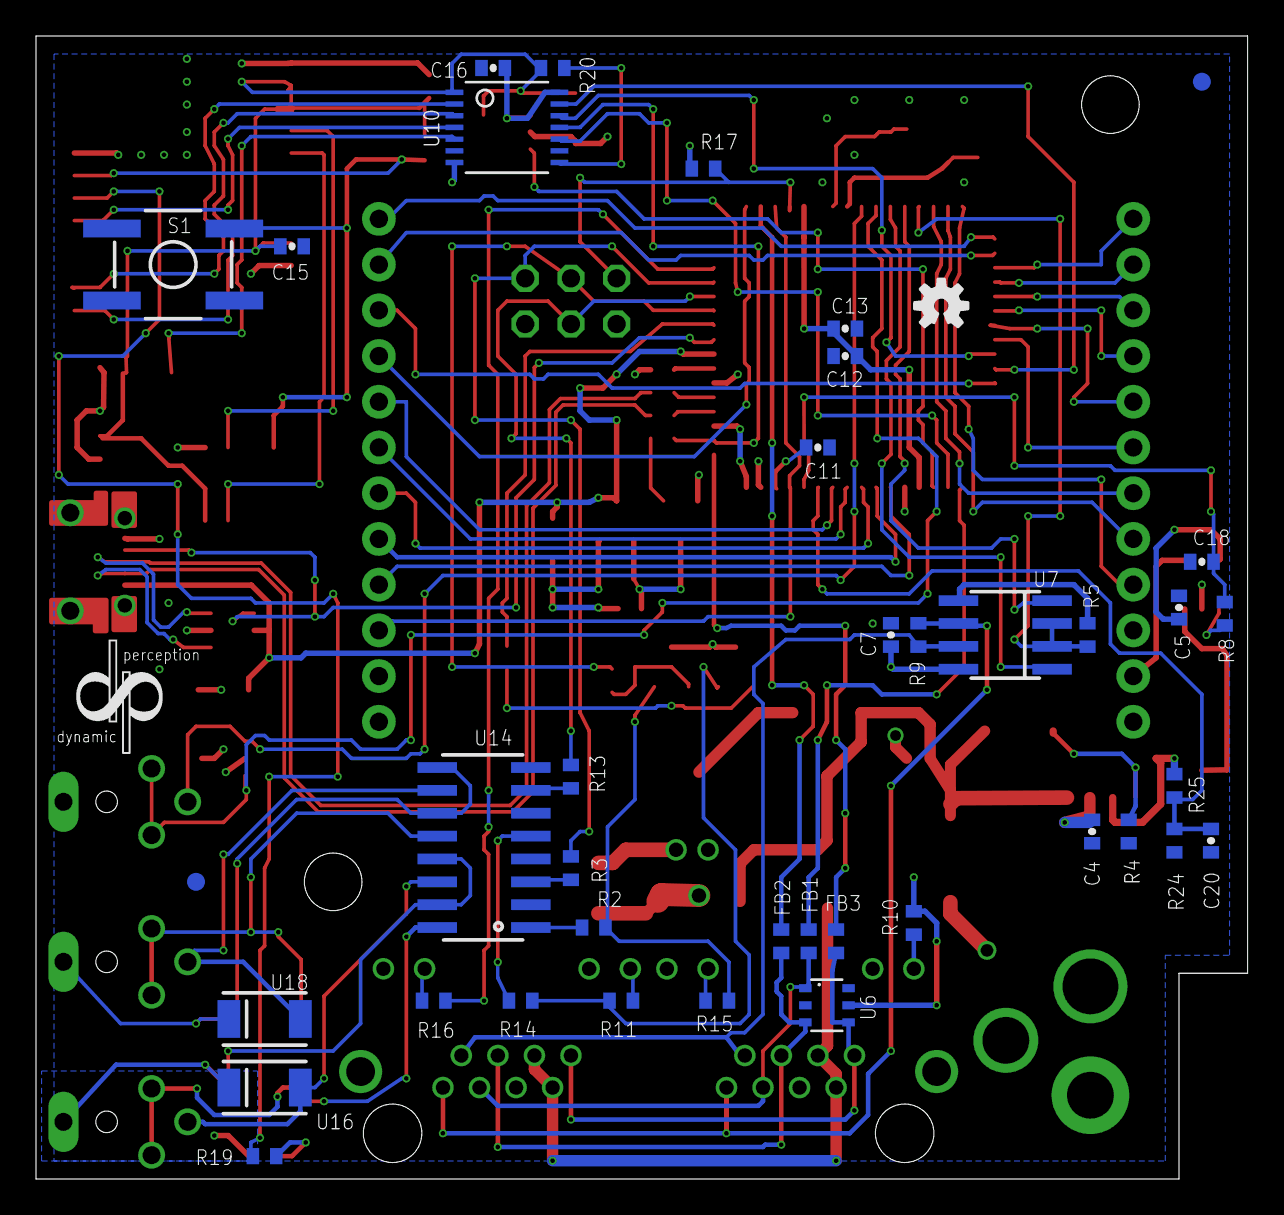
[picture p11: board NMX-200.brd from below]

Board: 4 copper layers, 67.3 x 63.5 mm, 94 parts (40 on the bottom side), 94 nets.
