DynamicPerception/NMX_3-Axis_Hardware/NMX-201.brd

## EAGLE design NMX-201.brd (2017-01-27)

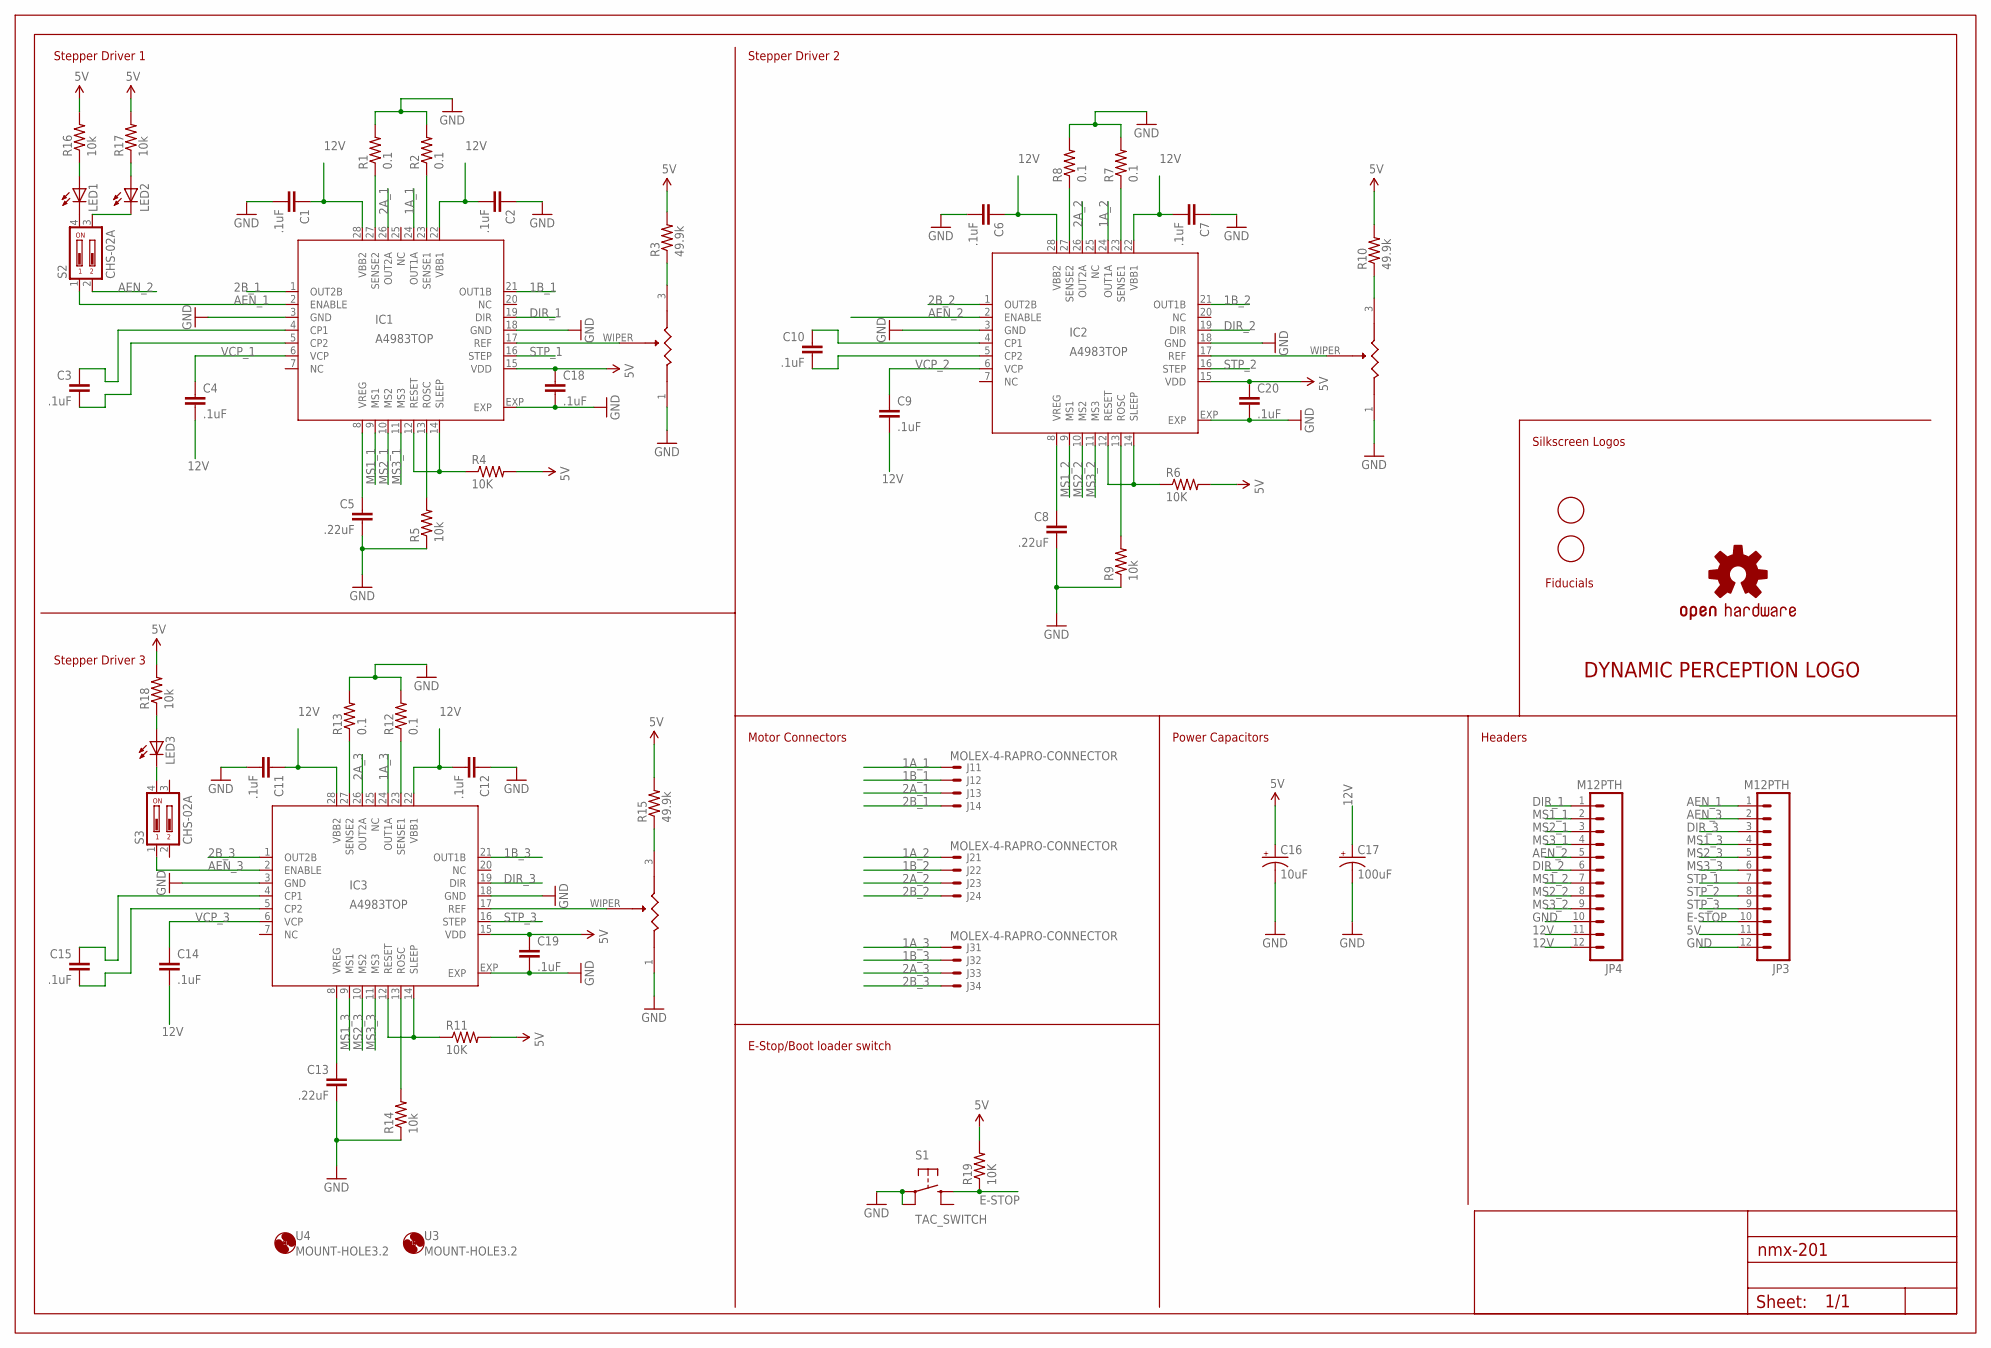
[picture p12: schematic NMX-201.sch]

Parts:
C1, C2, C3, C4, C6, C7, C9, C10, C11, C12, C14, C15, C18, C19, C20: .1uF; 0402-CAP; MPN TMK105BJ104KV-F
C5, C8, C13: .22uF; 0402-CAP; MPN TMK105BJ224KVHF
C16: 10uF; EIA3216; MPN T491A106M016AT
C17: 100uF; PANASONIC_D; MPN EEE-1EA101XP
FRAME2: A3L-LOCSILK_SCREEN; DRAWING_NAME
IC1, IC2, IC3: A4983TOP; QFN28ET; MPN A4983SETTR-T
J1, J2, J3: MOLEX-4-RAPRO-CONNECTOR; PRO_CONNECTOR; MPN 0022053041
JP3, JP4: M12PTH; 1X12; MPN 0901200132
LED1, LED2, LED3: LED0603; LED-0603; MPN LB Q39G-L2N2-35-1
R1, R2, R7, R8, R12, R13: 0.1; R0603; MPN RU1608FR100CS
R3, R10, R15: 49.9k; R0402_BOTTOM; MPN RC0402FR-0749K9L
R4, R6, R11, R19: 10K; R0402_BOTTOM; MPN RC0402FR-0710KL
R5, R9, R14: 10k; R0402_BOTTOM; MPN RC0402FR-0720KL
R16, R17, R18: 10k; R0402_BOTTOM; MPN RC0402FR-0714KL
S1: TAC_SWITCH; TAC_SWITCH_THR; MPN 2-1825027-0
S2, S3: CHS-02A
U1, U2, U5: CADJ; 3MM_SMD; MPN TC33X-2-103E
U3, U4: MOUNT-HOLE3.2; 3,2
U$1: DP_LOGOMICRO; DP_LOGO_MICRO
U$2: OSHW-LOGOS; OSHW-LOGO-S
U$3, U$4: FIDUCIAL; FIDUCIAL_1MM

Connections:
1A_1: IC1.24 (OUT1A), J1.P$1
1A_2: IC2.24 (OUT1A), J2.P$1
1A_3: IC3.24 (OUT1A), J3.P$1
1B_1: IC1.21 (OUT1B), J1.P$2
1B_2: IC2.21 (OUT1B), J2.P$2
1B_3: IC3.21 (OUT1B), J3.P$2
2A_1: IC1.26 (OUT2A), J1.P$3
2A_2: IC2.26 (OUT2A), J2.P$3
2A_3: IC3.26 (OUT2A), J3.P$3
2B_1: IC1.1 (OUT2B), J1.P$4
2B_2: IC2.1 (OUT2B), J2.P$4
2B_3: IC3.1 (OUT2B), J3.P$4
5V: C16.A (+), C18.1, C19.1, C20.1, IC1.15 (VDD), IC2.15 (VDD), IC3.15 (VDD), JP3.11, R3.2, R4.2, R6.2, R10.2, R11.2, R15.2, R16.2, R17.2, R18.2, R19.2
12V: C1.1, C2.2, C4.2, C6.1, C7.2, C9.2, C11.1, C12.2, C14.2, C17.+, IC1.22 (VBB1), IC1.28 (VBB2), IC2.22 (VBB1), IC2.28 (VBB2), IC3.22 (VBB1), IC3.28 (VBB2), JP4.11, JP4.12
AEN_1: IC1.2 (ENABLE), JP3.1, S2.1
AEN_2: IC2.2 (ENABLE), JP4.5, S2.2
AEN_3: IC3.2 (ENABLE), JP3.2, S3.1
ARST1: IC1.12 (RESET), IC1.14 (SLEEP), R4.1
ARST2: IC2.12 (RESET), IC2.14 (SLEEP), R6.1
ARST3: IC3.12 (RESET), IC3.14 (SLEEP), R11.1
DIR_1: IC1.19 (DIR), JP4.1
DIR_2: IC2.19 (DIR), JP4.6
DIR_3: IC3.19 (DIR), JP3.3
E-STOP: JP3.10, R19.1, S1.B (3)
GND: C1.2, C2.1, C5.2, C6.2, C7.1, C8.2, C11.2, C12.1, C13.2, C16.C (-), C17.-, C18.2, C19.2, C20.2, IC1.3 (GND), IC1.18 (GND), IC1.EXP, IC2.3 (GND), IC2.18 (GND), IC2.EXP, IC3.3 (GND), IC3.18 (GND), IC3.EXP, JP3.12, JP4.10, R1.2, R2.2, R5.1, R7.2, R8.2, R9.1, R12.2, R13.2, R14.1, S1.A (1), S1.P$1 (2), U1.1, U2.1, U5.1
MS1_1: IC1.9 (MS1), JP4.2
MS1_2: IC2.9 (MS1), JP4.7
MS1_3: IC3.9 (MS1), JP3.4
MS2_1: IC1.10 (MS2), JP4.3
MS2_2: IC2.10 (MS2), JP4.8
MS2_3: IC3.10 (MS2), JP3.5
MS3_1: IC1.11 (MS3), JP4.4
MS3_2: IC2.11 (MS3), JP4.9
MS3_3: IC3.11 (MS3), JP3.6
unnamed: C10.1, IC2.4 (CP1)
unnamed: C10.2, IC2.5 (CP2)
unnamed: IC2.23 (SENSE1), R7.1
unnamed: IC2.27 (SENSE2), R8.1
unnamed: IC2.17 (REF), U2.WIPER (2)
unnamed: R10.1, U2.3
unnamed: C15.1, IC3.4 (CP1)
unnamed: C15.2, IC3.5 (CP2)
unnamed: IC3.23 (SENSE1), R12.1
unnamed: IC3.27 (SENSE2), R13.1
unnamed: IC3.17 (REF), U5.WIPER (2)
unnamed: R15.1, U5.3
unnamed: LED1.A, R16.1
unnamed: LED2.A, R17.1
unnamed: LED3.A, R18.1
unnamed: LED1.C, S2.4
unnamed: LED2.C, S2.3
unnamed: LED3.C, S3.4
unnamed: C3.1, IC1.4 (CP1)
unnamed: C3.2, IC1.5 (CP2)
unnamed: IC1.23 (SENSE1), R2.1
unnamed: IC1.27 (SENSE2), R1.1
unnamed: IC1.17 (REF), U1.WIPER (2)
unnamed: R3.1, U1.3
ROSC1: IC1.13 (ROSC), R5.2
ROSC2: IC2.13 (ROSC), R9.2
ROSC3: IC3.13 (ROSC), R14.2
STP_1: IC1.16 (STEP), JP3.7
STP_2: IC2.16 (STEP), JP3.8
STP_3: IC3.16 (STEP), JP3.9
VCP_1: C4.1, IC1.6 (VCP)
VCP_2: C9.1, IC2.6 (VCP)
VCP_3: C14.1, IC3.6 (VCP)
VREG1: C5.1, IC1.8 (VREG)
VREG2: C8.1, IC2.8 (VREG)
VREG3: C13.1, IC3.8 (VREG)

Notes on the sheet:
Stepper Driver 1
Stepper Driver 2
Stepper Driver 3
Motor Connectors
E-Stop/Boot loader switch
Headers
Power Capacitors
Silkscreen Logos
Fiducials

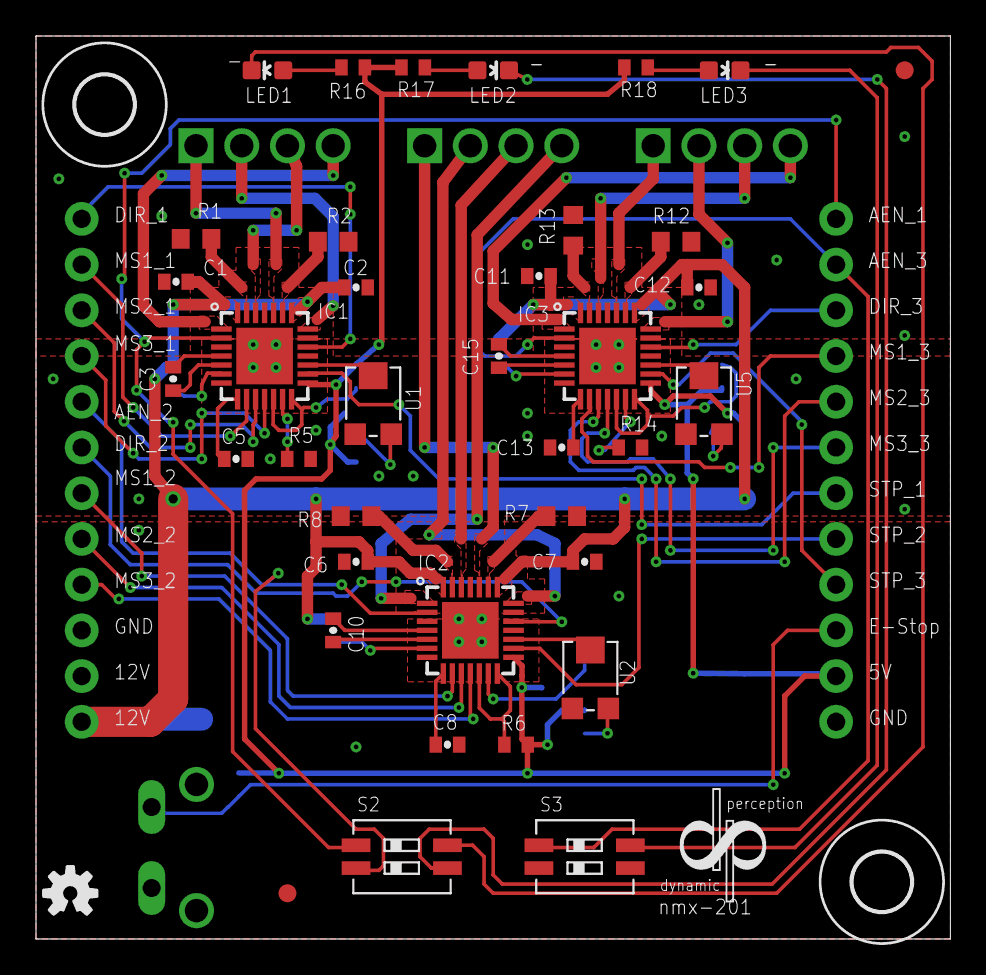
[picture p13: board NMX-201.brd from above]

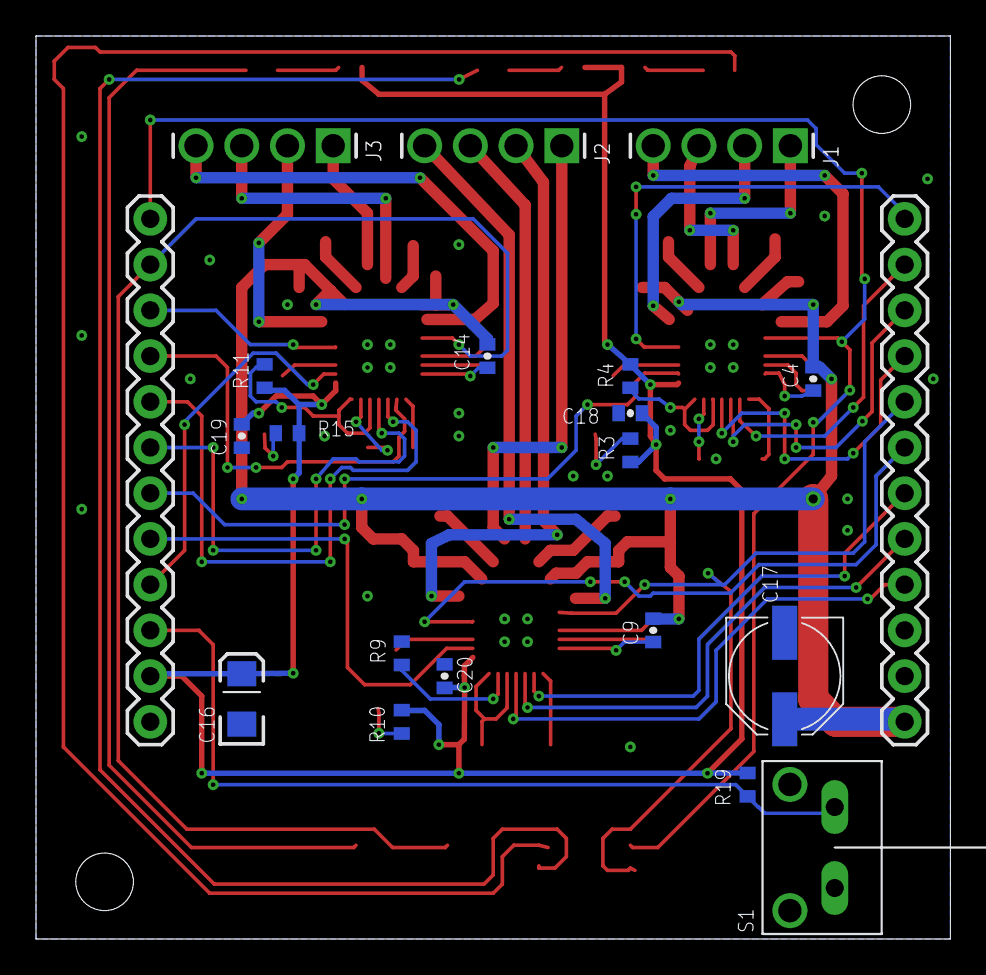
[picture p14: board NMX-201.brd from below]

Board: 2 copper layers, 50.8 x 50.2 mm, 63 parts (20 on the bottom side), 70 nets.
