DynamicPerception/NMX_3-Axis_Hardware/(commit log)

2014-08-26 Initial GitHub upload - 8/26/14
    To do:
    --Update ESD suppressors on phototransistors from 5V to 80V limit.
    --Change trace width from .024 to .025 on all traces from motor headers
    [NMX-200.brd, NMX-200.sch, NMX-201.brd, NMX-201.sch]
2014-08-27 Board Updates
    Changed TVS diodes for isolated jack for 200, changed a few traces in
    201
2014-08-27 Updated TVS Attributes
    [NMX-200.brd, NMX-200.sch]
2014-08-27 Fixed NMX-200 schematic typo
    Two 10k resistors were marked with an upper case "K" instead of lower
    case k", which caused them to appear as a separate line on the exported
    BOM.
    [NMX-200.brd, NMX-200.sch]
2014-08-27 Upload of fabrication data
    Upload of ZIP files containing Gerber files, BOMs, and assembly drawings
    for each board.
2014-08-27 Fixed fabrication data upload
    Accidentally uploaded the NMX-200 CAM zip instead of the NMX-201
    fabrication zip. Also unzipped everything in those files and put them in
    normal folders.
    [NMX-200-rev2 PCB FAB Engineering CheckList.xls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]
2014-09-30 Changed silkscreen to indicate polarity of some components
    [NMX-200.brd, NMX-200.sch]
2014-10-03 Update to Silk Screen
    [NMX-201.brd, NMX-201.sch]
2014-10-03 Update Silk Screen
    [NMX-200.brd, NMX-200.sch]
2015-01-23 Replaced 5V regulator with cold-resistant model
    The MC78M05CDTG ON-Semiconductor regulator was replaced with the
    MC78M05BDTG. The minimum operating temperature of former is 0°C and the
    latter is -45°C. There have been issues connecting to the NMX via
    Bluetooth when it is very cold, so this change is being made in an
    attempt to address that issue.
    The CAM files have not changed at all, but their names have been updated
    to Rev 3.
    [NMX-200-rev2 PCB FAB Engineering CheckList.xls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]
2016-03-18 Added NMX-201-B
    [NMX-201-B-rev2 PCB FAB Engineering CheckList.xls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]
2016-03-18 Added NMX-200 and NMX-201 schematic PDFs
2016-08-18 Changed NMX 200 to 4 layer design
    [NMX-200.brd, NMX-200.sch]
2016-08-19 Fixed broken route, moved oscilator caps to top layer
    [NMX-200.brd]
2016-08-23 Added DIP switches and increased LED resistor vals
    NMX 201-B:
    - Added switches to allow users to turn off motor movement indicator
    LEDs.
    - Changed R16, R17, R19 to 14k resistances in order to reduce LED
    brightness.
    [NMX-201-B.brd, NMX-201-B.sch]
2016-08-23 Updated NMX-201 to match NMX-201B
    The only difference between NMX-201 and NMX-201B is whether the the
    component attached to the motor connector ports is a screw terminal or a
    Molex connector, so there's really no need to maintain two different
    schematics / board files. These differences should be reflected in the
    BOM instead.
    [NMX-201.brd, NMX-201.sch]
2016-08-29 Fixed DRC errors
    [NMX-200.brd, NMX-200.sch]
2016-09-15 Moved USB connector, fixed DRC errors
    Moved the connector slightly closer to the edge of the board and updated
    part with revised library part that addresses DRC errors.
    [NMX-200.brd, NMX-200.sch]
2016-09-15 Tented vias
    Changed DRC rules to not add stop mask to vias.
    [NMX-200.brd, NMX-201.brd]
2016-09-16 Fixed incomplete board outline
    [NMX-200.brd]
2016-09-16 Added copper plane clearance from board edge
    [NMX-200.brd]
2016-09-16 Added fiducials to bottom of NMX-200
    [NMX-200.brd, NMX-200.sch]
2016-11-21 Removed NMX-201-B files
    The PCB is identical for the 201 and 201-B boards, only the connector
    part is different. No need to maintain two different Eagle files.
    [NMX-201-B.brd, NMX-201-B.sch]
2016-12-15 Fixed some ERC errors, switched to OSHPark DRC
    [NMX-200.brd, NMX-200.sch]
2016-12-15 Added "Rev 5" silkscreen marker
    [NMX-200.brd]
2016-12-15 Changed several resistor values to reduce unique part count
    See NMX-200 / NMX-201 BOM Google doc change log for 12/15/16 for
    details.
    [NMX-200.brd, NMX-200.sch, NMX-201.brd, NMX-201.sch]
2017-01-19 Rev 3 BOM update
    [NMX-200_BOM-rev3.xls]
2017-01-19 Added via tenting
    [NMX-200.brd]
2017-01-19 Corrected header silk screen labels
    [NMX-200.brd]
2017-01-27 Increased copper pour isolation, fixed DC jack holes
    On the first prototype boards, a manufacturing defect caused the ground
    plane to make contact with one of the via pads, causing a very difficult
    to identify problem with BLE connectivity. The clearance between both
    GND and 5V copper pours and traces, vias, and pads has been increased to
    avoid this in the future.
    The drill holes for the DC jack were just a bit too small, so they have
    been modified to allow for easy insertion of the component.
    [NMX-200.brd, NMX-200.sch]
